TomKeddie/prj-keypad-six/hardware/keypad-base/dxf/keypad-base-Jun2021.dxf

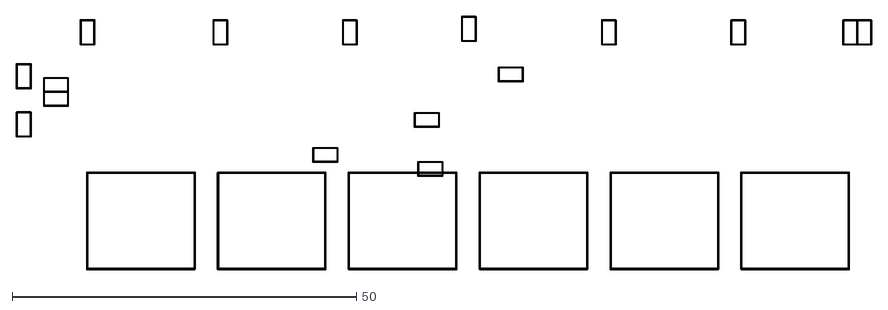
[picture p2: CAD file, 2021-04-25]
hardware/keypad-base/dxf/keypad-base-Jun2021.dxf
124.1 x 36.7
