TomKeddie/prj-keypad-six/hardware/keypad-base-rp2040/keypad-base-rp2040.kicad_pcb

## KiCad design hardware/keypad-base-rp2040/keypad-base-rp2040.kicad_pcb (2022-09-04)

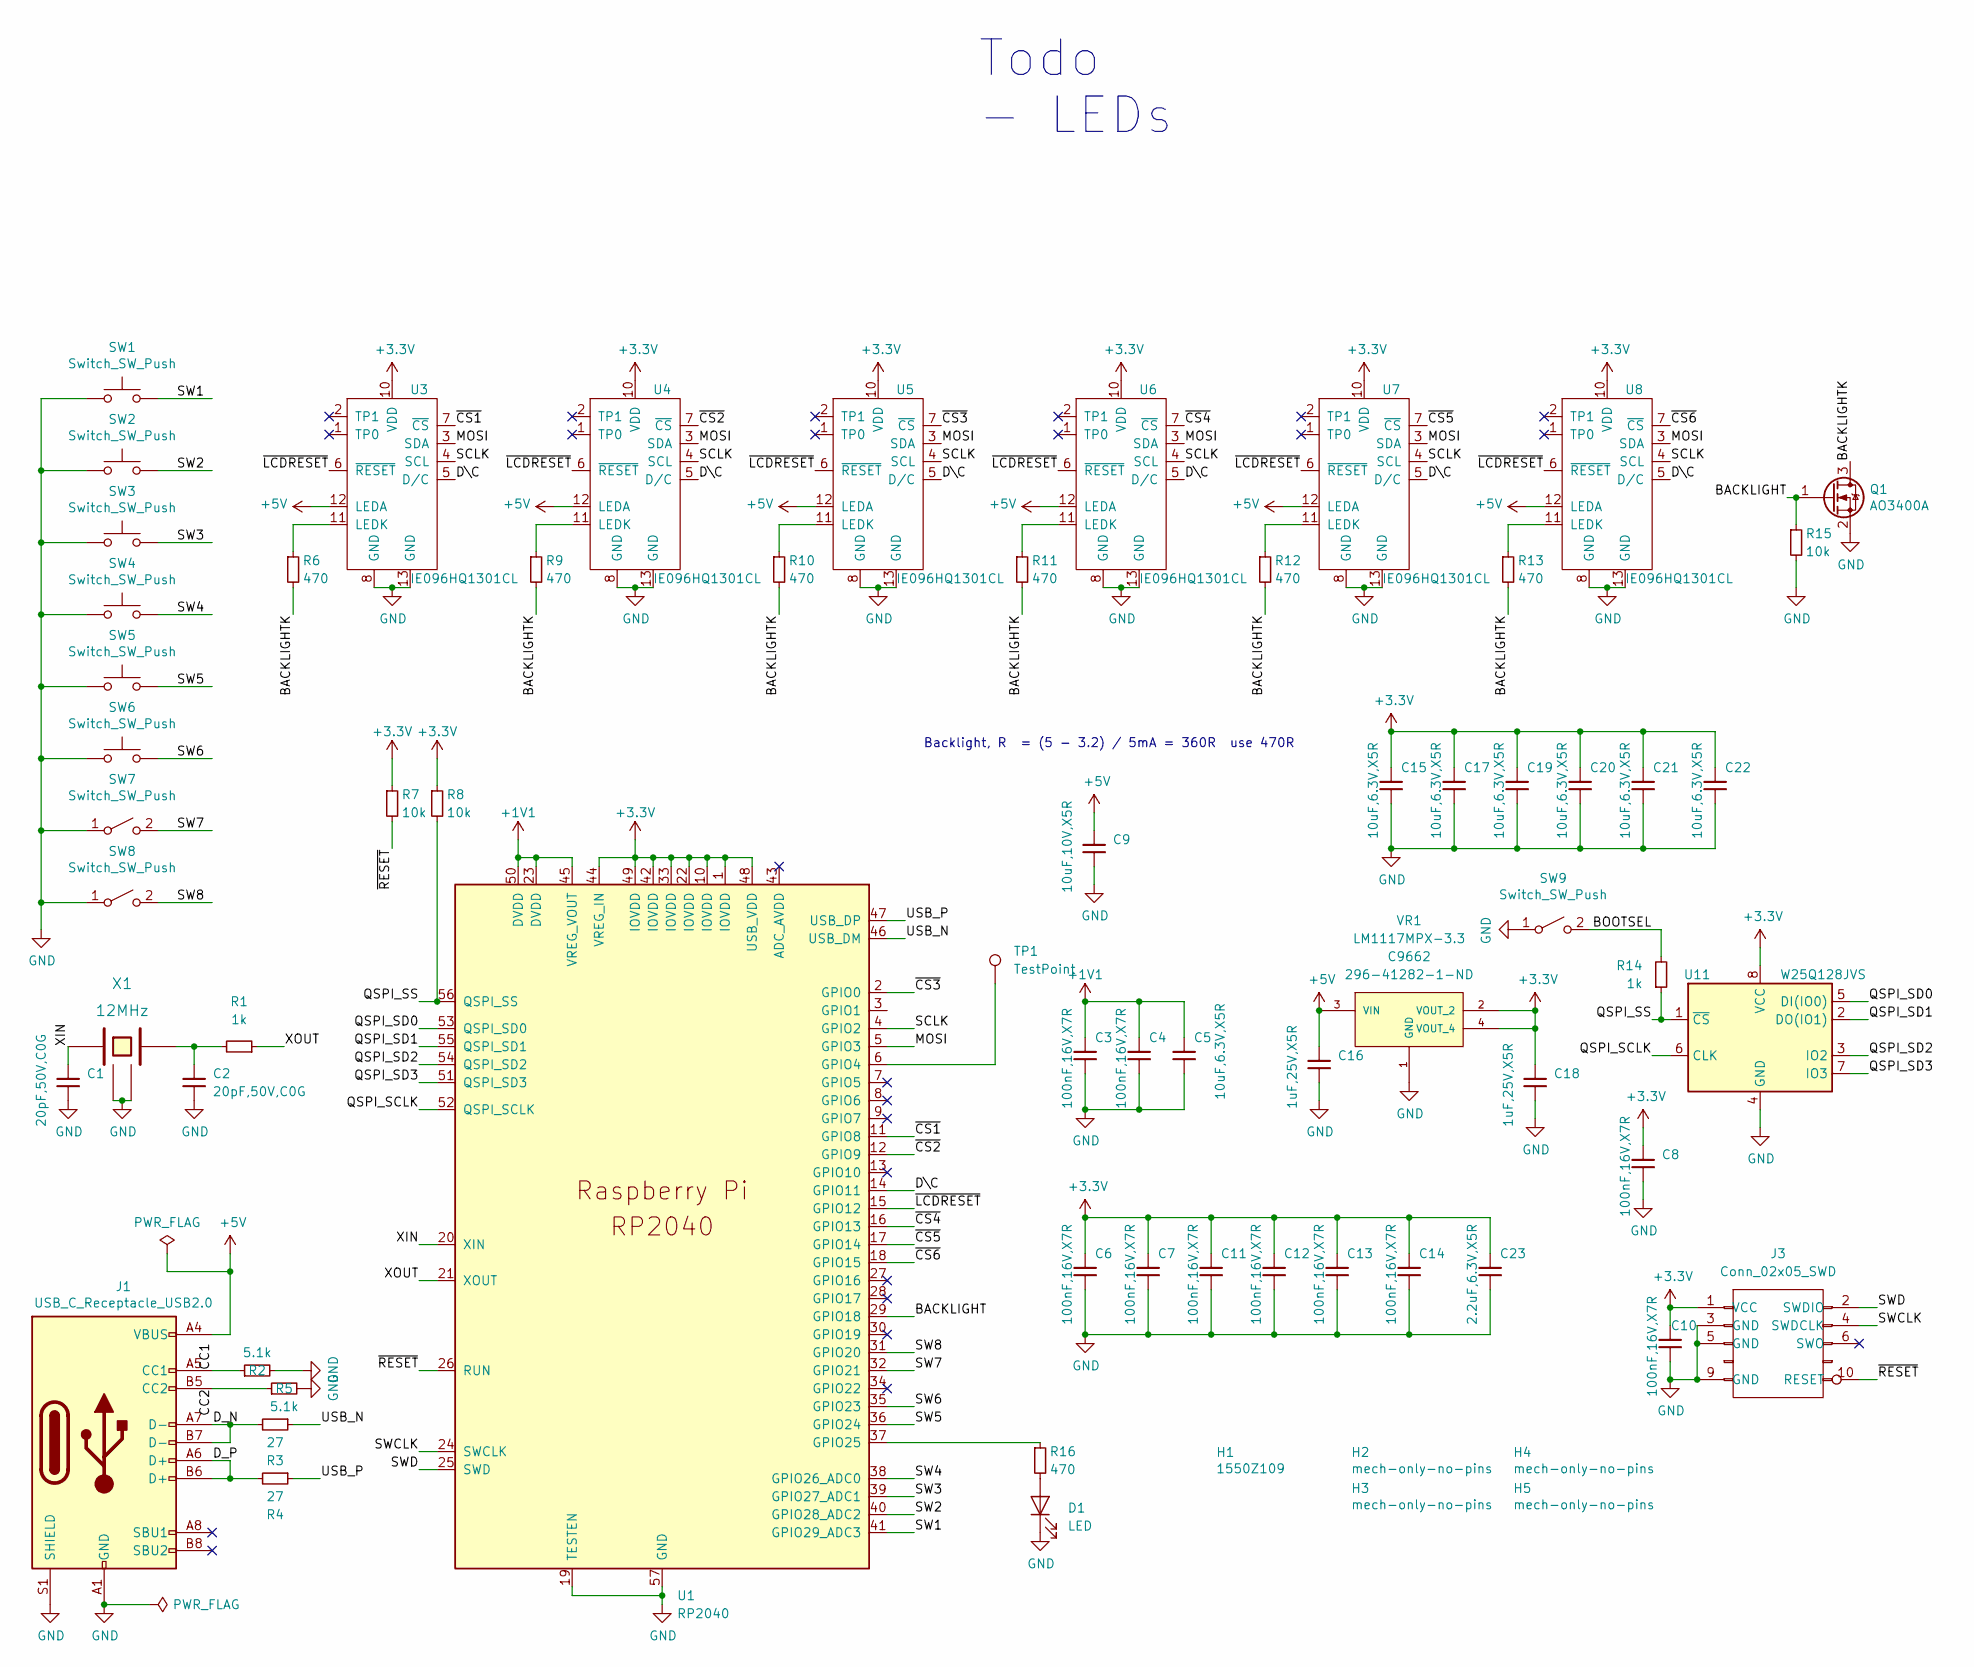
[picture p3: schematic keypad-base-rp2040.kicad_sch]

Parts:
C1, C2: 20pF,50V,C0G; C_0402_1005Metric; MFGPN 0402CG200J500NT; LCSC C1554
C3, C4, C6, C7, C8, C10, C11, C12, C13, C14: 100nF,16V,X7R; C_0402_1005Metric; MFGPN CL05B104KO5NNNC; LCSC C1525
C5, C15, C17, C19, C20, C21, C22: 10uF,6.3V,X5R; C_0402_1005Metric; MFGPN CL05A106MQ5NUNC; LCSC C15525
C9: 10uF,10V,X5R; C_0603_1608Metric; MFGPN CL10A106KP8NNNC; LCSC C19702
C16, C18: 1uF,25V,X5R; C_0402_1005Metric; MFGPN CL05A105KA5NQNC; LCSC C52923
C23: 2.2uF,6.3V,X5R; C_0402_1005Metric; MFGPN CL05A225MQ5NSNC; LCSC C12530
D1: LED; LED_0805_2012Metric; LCSC C2296
H1: 1550Z109
H2, H3, H4, H5: mech-only-no-pins; STUD_SOLDER_SMTSO_M3
J1: USB_C_Receptacle_USB2.0; USB_C_Receptacle_GT-USB-7010; LCSC C709357
J3: Conn_02x05_SWD; FTSH-105-01-F-DV-K
Q1: AO3400A; SOT-23; LCSC C20917
R1, R14: 1k; R_0402_1005Metric; MFGPN 0402WGF1001TCE; LCSC C11702
R2, R5: 5.1k; R_0402_1005Metric; MFGPN 0402WGF5101TCE; LCSC C25905
R3, R4: 27; R_0603_1608Metric; MFGPN 0603WAF270JT5E; LCSC C25190
R6, R9, R10, R11, R12, R13, R16: 470; R_0402_1005Metric; MFGPN 0402WGF4700TCE; LCSC C25117
R7, R8, R15: 10k; R_0402_1005Metric; MFGPN 0402WGF1002TCE; LCSC C25744
SW1, SW2, SW3, SW4, SW5, SW6: Switch_SW_Push; MX-KailhClip-1.00u-no-top-ring; LCSC C2803348
SW7, SW8, SW9: Switch_SW_Push; SW_SPST_SMD_SIDE_C319395; LCSC C319395
TP1: TestPoint; TestPoint_Pad_D1.0mm
U1: RP2040; RP2040-QFN-56; LCSC C2040
U3, U4, U5, U6, U7, U8: IE096HQ1301CL
U11: W25Q128JVS; SOIC-8_5.23x5.23mm_P1.27mm; LCSC C97521
VR1: LM1117MPX-3.3; VREG_LM1117MPX-3.3; PARTREV O; LCSC C9662
X1: 12MHz; Crystal_SMD_3225-4Pin_3.2x2.5mm; LCSC C9002

Connections:
+1V1: C3.1, C4.1, C5.1, U1.23 (DVDD), U1.45 (VREG_VOUT), U1.50 (DVDD)
+3.3V: C6.1, C7.1, C8.1, C10.1, C11.1, C12.1, C13.1, C14.1, C15.1, C17.1, C18.1, C19.1, C20.1, C21.1, C22.1, C23.1, J3.1 (VCC), R7.1, R8.1, U1.1 (IOVDD), U1.10 (IOVDD), U1.22 (IOVDD), U1.33 (IOVDD), U1.42 (IOVDD), U1.44 (VREG_IN), U1.48 (USB_VDD), U1.49 (IOVDD), U3.10 (VDD), U4.10 (VDD), U5.10 (VDD), U6.10 (VDD), U7.10 (VDD), U8.10 (VDD), U11.8 (VCC), VR1.2 (VOUT_2), VR1.4 (VOUT_4)
+5V: C9.1, C16.1, J1.A4 (VBUS), J1.A9 (VBUS), J1.B4 (VBUS), J1.B9 (VBUS), U3.12 (LEDA), U4.12 (LEDA), U5.12 (LEDA), U6.12 (LEDA), U7.12 (LEDA), U8.12 (LEDA), VR1.3 (VIN)
/BACKLIGHT: Q1.1 (G), R15.1, U1.29 (GPIO18)
/BACKLIGHTK: Q1.3 (D), R6.2, R9.2, R10.2, R11.2, R12.2, R13.2
/BOOTSEL: R14.2, SW9.2 (B)
/CC1: J1.A5 (CC1), R2.1
/CC2: J1.B5 (CC2), R5.1
/D\C: U1.14 (GPIO11), U3.5 (D/C), U4.5 (D/C), U5.5 (D/C), U6.5 (D/C), U7.5 (D/C), U8.5 (D/C)
/D_N: J1.A7 (D-), J1.B7 (D-), R3.2
/D_P: J1.A6 (D+), J1.B6 (D+), R4.2
/MOSI: U1.5 (GPIO3), U3.3 (SDA), U4.3 (SDA), U5.3 (SDA), U6.3 (SDA), U7.3 (SDA), U8.3 (SDA)
/QSPI_SCLK: U1.52 (QSPI_SCLK), U11.6 (CLK)
/QSPI_SD0: U1.53 (QSPI_SD0), U11.5 (DI(IO0))
/QSPI_SD1: U1.55 (QSPI_SD1), U11.2 (DO(IO1))
/QSPI_SD2: U1.54 (QSPI_SD2), U11.3 (IO2)
/QSPI_SD3: U1.51 (QSPI_SD3), U11.7 (IO3)
/QSPI_SS: R8.2, R14.1, U1.56 (QSPI_SS), U11.1 (~CS)
/SCLK: U1.4 (GPIO2), U3.4 (SCL), U4.4 (SCL), U5.4 (SCL), U6.4 (SCL), U7.4 (SCL), U8.4 (SCL)
/SW1: SW1.2, U1.41 (GPIO29_ADC3)
/SW2: SW2.2, U1.40 (GPIO28_ADC2)
/SW3: SW3.2, U1.39 (GPIO27_ADC1)
/SW4: SW4.2, U1.38 (GPIO26_ADC0)
/SW5: SW5.2, U1.36 (GPIO24)
/SW6: SW6.2, U1.35 (GPIO23)
/SW7: SW7.2 (B), U1.32 (GPIO21)
/SW8: SW8.2 (B), U1.31 (GPIO20)
/SWCLK: J3.4 (SWDCLK), U1.24 (SWCLK)
/SWD: J3.2 (SWDIO), U1.25 (SWD)
/USB_N: R3.1, U1.46 (USB_DM)
/USB_P: R4.1, U1.47 (USB_DP)
/XIN: C1.1, U1.20 (XIN), X1.1
/XOUT: R1.1, U1.21 (XOUT)
/~CS1: U1.11 (GPIO8), U3.7 (~CS)
/~CS2: U1.12 (GPIO9), U4.7 (~CS)
/~CS3: U1.2 (GPIO0), U5.7 (~CS)
/~CS4: U1.16 (GPIO13), U6.7 (~CS)
/~CS5: U1.17 (GPIO14), U7.7 (~CS)
/~CS6: U1.18 (GPIO15), U8.7 (~CS)
/~LCDRESET: U1.15 (GPIO12), U3.6 (~RESET), U4.6 (~RESET), U5.6 (~RESET), U6.6 (~RESET), U7.6 (~RESET), U8.6 (~RESET)
/~RESET: J3.10 (RESET), R7.2, U1.26 (RUN)
GND: C1.2, C2.2, C3.2, C4.2, C5.2, C6.2, C7.2, C8.2, C9.2, C10.2, C11.2, C12.2, C13.2, C14.2, C15.2, C16.2, C17.2, C18.2, C19.2, C20.2, C21.2, C22.2, C23.2, D1.1 (K), J1.A1 (GND), J1.A12 (GND), J1.B1 (GND), J1.B12 (GND), J1.S1 (SHIELD), J3.3 (GND), J3.5 (GND), J3.9 (GND), Q1.2 (S), R2.2, R5.2, R15.2, SW1.1, SW2.1, SW3.1, SW4.1, SW5.1, SW6.1, SW7.1 (A), SW8.1 (A), SW9.1 (A), U1.19 (TESTEN), U1.57 (GND), U3.8 (GND), U3.13 (GND), U4.8 (GND), U4.13 (GND), U5.8 (GND), U5.13 (GND), U6.8 (GND), U6.13 (GND), U7.8 (GND), U7.13 (GND), U8.8 (GND), U8.13 (GND), U11.4 (GND), VR1.1 (GND), X1.2 (GND), X1.4 (GND)
unnamed: C2.1, R1.2, X1.3
unnamed: D1.2 (A), R16.2
unnamed: R6.1, U3.11 (LEDK)
unnamed: R9.1, U4.11 (LEDK)
unnamed: R10.1, U5.11 (LEDK)
unnamed: R11.1, U6.11 (LEDK)
unnamed: R12.1, U7.11 (LEDK)
unnamed: R13.1, U8.11 (LEDK)
unnamed: R16.1, U1.37 (GPIO25)
unnamed: TP1.1, U1.6 (GPIO4)

Notes on the sheet:
Backlight, R = (5 - 3.2) / 5mA = 360R use 470R
Todo - LEDs

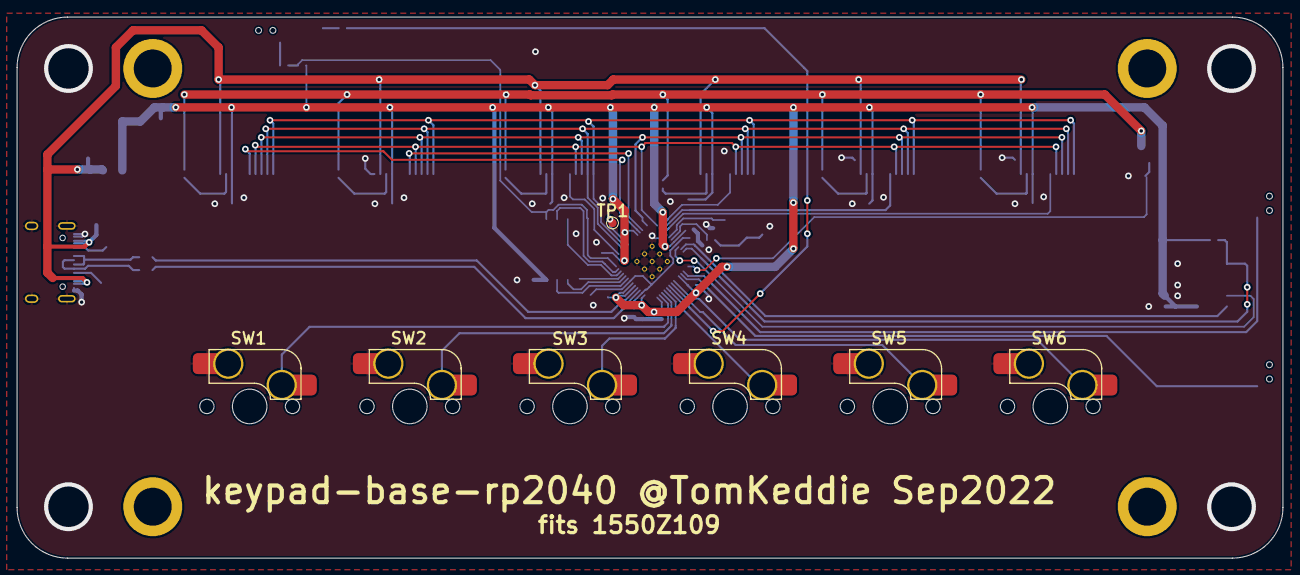
[picture p4: board keypad-base-rp2040.kicad_pcb from above]

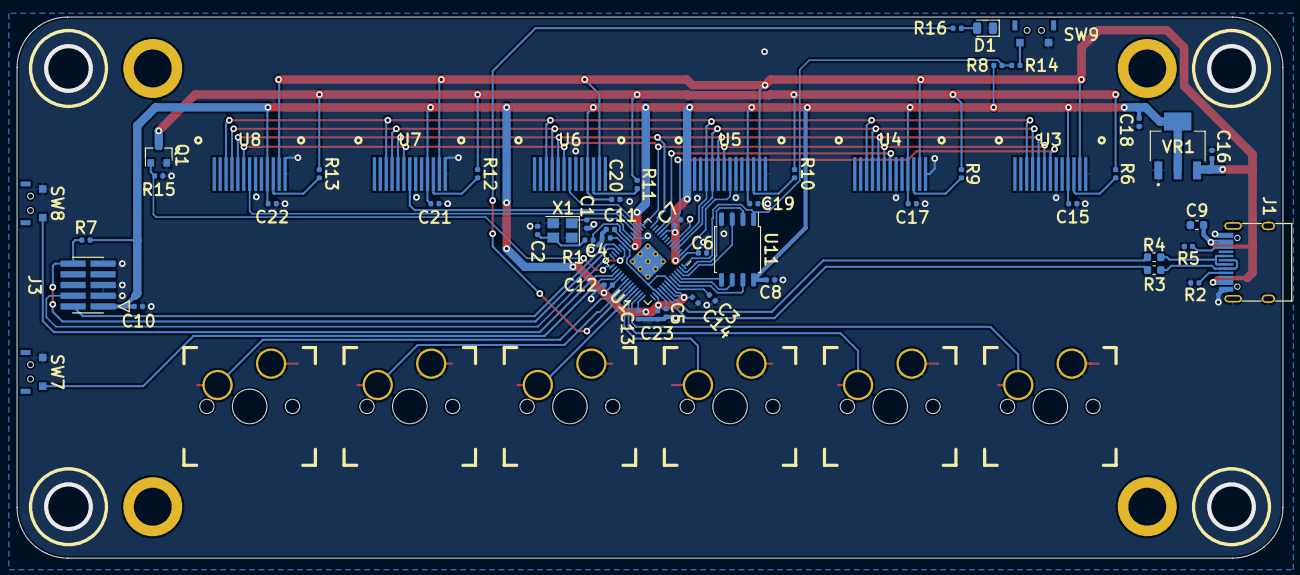
[picture p5: board keypad-base-rp2040.kicad_pcb from below]

Board: 2 copper layers, 150.2 x 64.2 mm, 68 parts (60 on the bottom side), 52 nets.
