TomKeddie/prj-keypad-six/(commit log)

2021-04-25 keypad-base: new design
    [keypad-base.kicad_pcb, keypad-base.sch]
2021-04-25 keypad-base: reduced to 6 keys, add mode change side buttons
    [keypad-base.kicad_pcb, keypad-base.sch]
2021-04-25 keypad-base: Apr2021 release
    [keypad-base-Apr2021.dxf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]
2021-04-25 keypad-frame: Apr2021 release of keypad frame
    [keypad-frame-Apr2021.drl, keypad-frame-B_Adhes.gbr, keypad-frame-B_CrtYd.gbr, keypad-frame-B_Cu.gbr, keypad-frame-B_Fab.gbr, keypad-frame-B_Mask.gbr, keypad-frame-B_Paste.gbr, keypad-frame-B_SilkS.gbr]
2021-04-25 keypad-base: fix silk, add missing edge cuts layer
    [keypad-base-Apr2021.dxf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]
2021-04-26 keypad-base/keypad-frame: change to M2 standoffs, Apr2021a release
    [keypad-base-Apr2021a.drl, keypad-base-B_Adhes.gbr, keypad-base-B_CrtYd.gbr, keypad-base-B_Cu.gbr, keypad-base-B_Fab.gbr, keypad-base-B_Mask.gbr, keypad-base-B_Paste.gbr, keypad-base-B_SilkS.gbr]
2021-05-30 keypad-frame: May2021 release, change to m3 holes, shrink keyswitch cutouts
    [keypad-frame-B_Adhes.gbr, keypad-frame-B_CrtYd.gbr, keypad-frame-B_Cu.gbr, keypad-frame-B_Fab.gbr, keypad-frame-B_Mask.gbr, keypad-frame-B_Paste.gbr, keypad-frame-B_SilkS.gbr, keypad-frame-Edge_Cuts.gbr]
2021-06-06 keypad-base: Jun2021 - change standoff type
    [keypad-base-Apr2021a.dxf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]
2022-01-17 Fix submodules & restructure dirs
    [keypad-base-Apr2021.dxf, keypad-base-Apr2021a.dxf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]
2022-01-18 keypad-six-test: 2 buttons working, 6 keys working, spi test
2022-01-19 hardware: directory restructure
    [keypad-base-Apr2021.dxf, keypad-base-Apr2021a.dxf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]
2022-01-19 software: add test for spi flash
2022-01-22 software/keypad-six-test: add lcd driver with test image
2022-08-25 hardware: move keyboard io footprints to parent dir
2022-08-25 hardware: keypad-base-rp2040 from keypad-base
    [keypad-base-rp2040.kicad_pcb, keypad-base-rp2040.sch]
2022-08-25 hardware/keypad-base-rp2040: update to latest kicad file format
    [keypad-base-rp2040.kicad_pcb]
2022-08-28 hardware/keypad0base-rp2040: first pass at rp2040 based design
    [keypad-base-rp2040.kicad_pcb, keypad-base-rp2040.kicad_sch, keypad-base-rp2040.sch]
2022-09-03 hardware/keypad-base-rp2040: progress commit
    [keypad-base-rp2040.kicad_pcb, keypad-base-rp2040.kicad_sch]
2022-09-04 hardware/keypad-base-rp2040: placed, routed, ERC & DRC clean
    [keypad-base-rp2040.kicad_pcb, keypad-base-rp2040.kicad_sch]
2022-09-04 hardware/keypad-frame: Sep2022a version
    Reduced keyswitch opening by 0.2mm
    [keypad-frame-B_Cu.gbr, keypad-frame-B_Mask.gbr, keypad-frame-B_Paste.gbr, keypad-frame-B_Silkscreen.gbr, keypad-frame-Edge_Cuts.gbr, keypad-frame-F_Cu.gbr, keypad-frame-F_Mask.gbr, keypad-frame-F_Paste.gbr]
2022-09-04 hardare/keypad-base-rp2040: Sep2022 as submitted
    [keypad-base-rp2040-B_Cu.gbl, keypad-base-rp2040-B_Mask.gbs, keypad-base-rp2040-B_Paste.gbp, keypad-base-rp2040-B_Silkscreen.gbo, keypad-base-rp2040-Edge_Cuts.gm1, keypad-base-rp2040-F_Cu.gtl, keypad-base-rp2040-F_Mask.gts, keypad-base-rp2040-F_Paste.gtp]
